amirashv/YET/yeti24/cad/step/ir_led_case.step

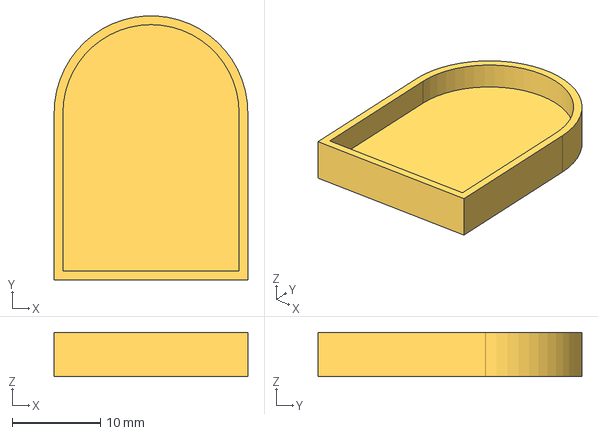
[picture p1: CAD file, 2026-02-17]
yeti24/cad/step/ir_led_case.step
22.0 x 30.0 x 5.00 mm
