amirashv/YET/yeti24/cad/stl/et_mount.step.stl

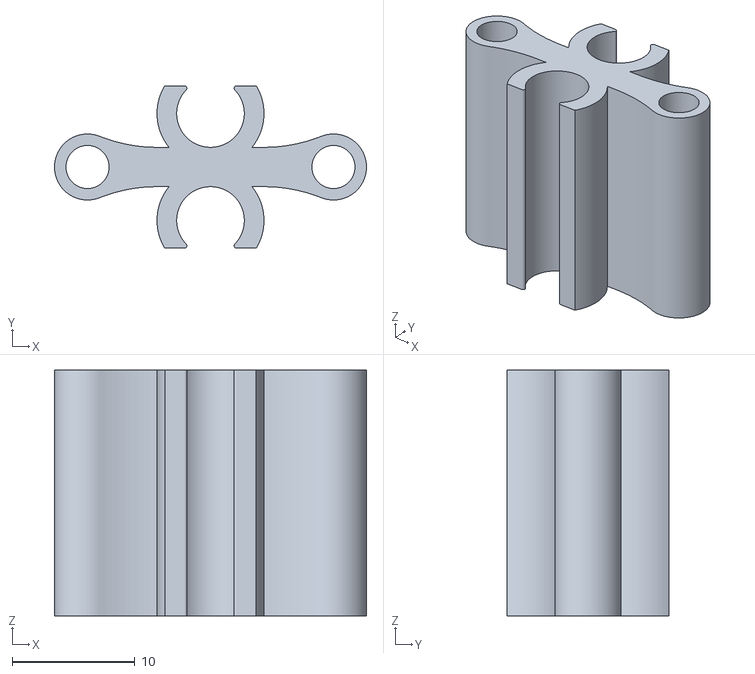
[picture p2: CAD file, 2026-02-17]
yeti24/cad/stl/et_mount.step.stl
25.4 x 13.2 x 20.0
