amirashv/YET/yeti24/cad/step/barebone_clip.step

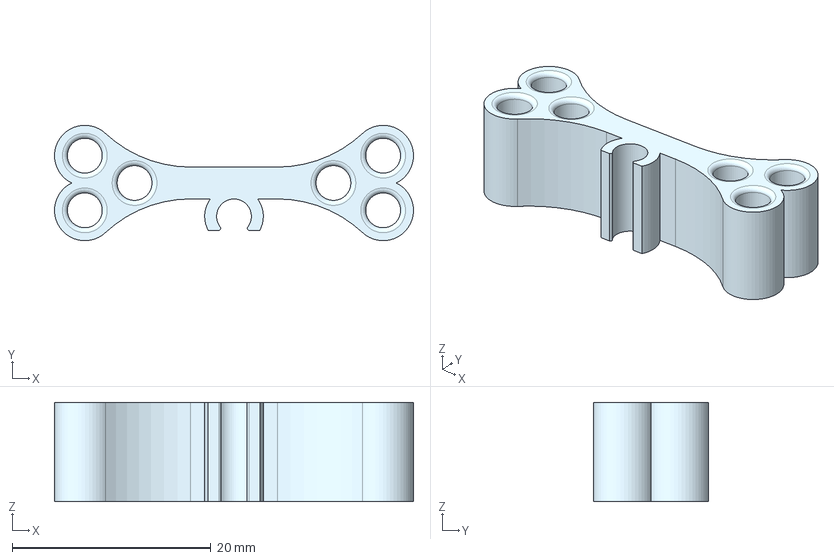
[picture p3: CAD file, 2026-02-17]
yeti24/cad/step/barebone_clip.step
36.1 x 11.6 x 10.0 mm
