amirashv/YET/yeti24/cad/step/hook.step

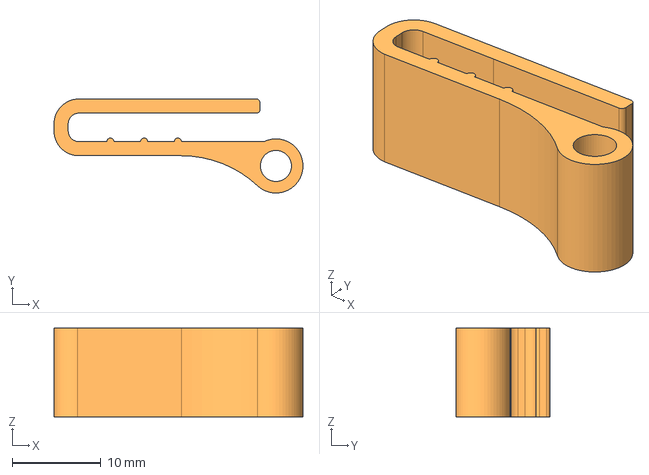
[picture p4: CAD file, 2026-02-17]
yeti24/cad/step/hook.step
28.0 x 10.6 x 10.0 mm
