amirashv/YET/yeti24/cad/step/wire_cap.step

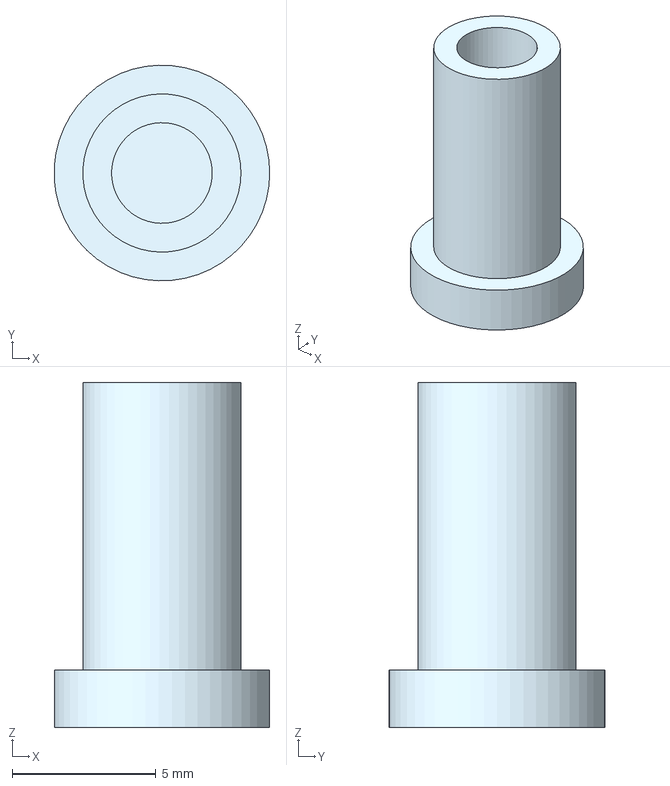
[picture p5: CAD file, 2026-02-17]
yeti24/cad/step/wire_cap.step
7.49 x 7.50 x 12.0 mm
