amirashv/YET/yeti24/cad/step/xwing_barebone.step

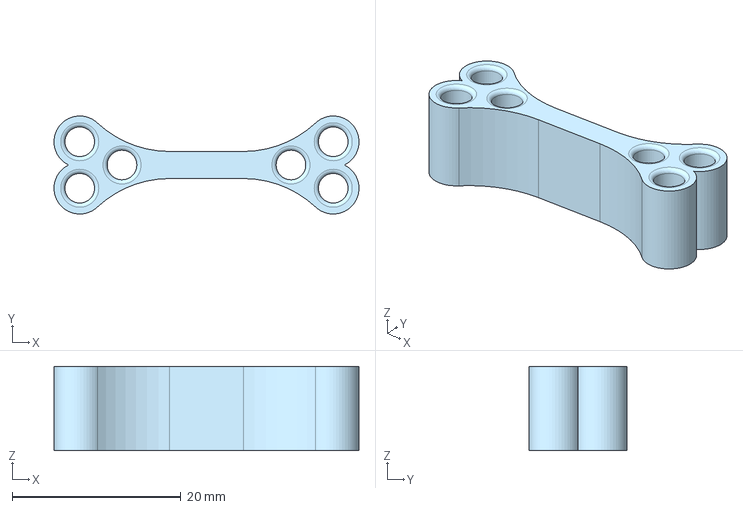
[picture p6: CAD file, 2026-02-17]
yeti24/cad/step/xwing_barebone.step
36.1 x 11.6 x 10.0 mm
