amirashv/YET/yeti24/cad/step/ir_led_clip.step

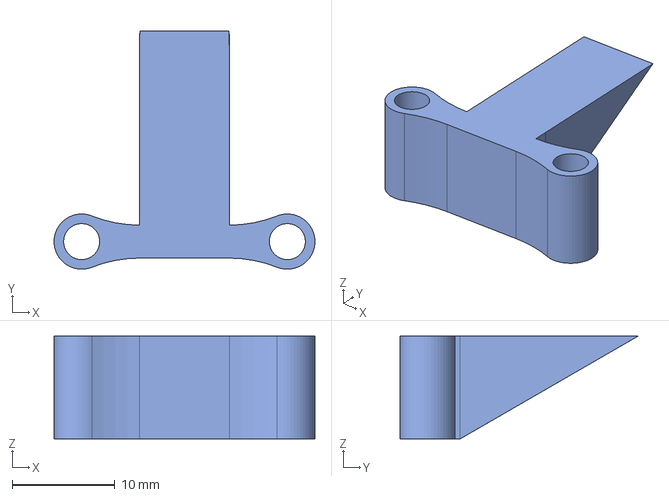
[picture p7: CAD file, 2026-02-17]
yeti24/cad/step/ir_led_clip.step
25.4 x 23.2 x 10.0 mm
