amirashv/YET/yeti24/cad/step/hook_barebone_clip.step

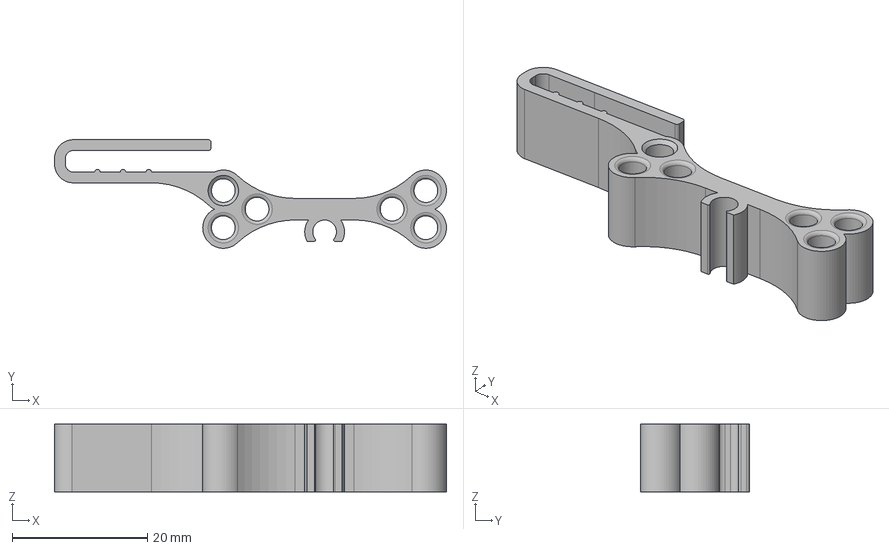
[picture p8: CAD file, 2026-02-17]
yeti24/cad/step/hook_barebone_clip.step
58.0 x 16.1 x 10.0 mm
