amirashv/YET/(list of files, cad)

Other CAD files:
yeti24/cad/step/et_mount.step
yeti24/cad/stl/barebone_clip.stl
yeti24/cad/stl/hook.stl
yeti24/cad/stl/hook_barebone_clip.stl
yeti24/cad/stl/ir_led_case.stl
yeti24/cad/stl/ir_led_clip.stl
yeti24/cad/stl/wire_cap.stl
yeti24/cad/stl/xwing_barebone.stl
