amirashv/YET/(commit log)

2025-11-21 Configure USB index for YET camera
    [Config.csv]
2026-02-17 chore: ignore macOS .DS_Store
    [AOI.csv, Config.csv, Stimuli.csv, Stimuli_short.csv, Yeta1_DemoMS1770558810.csv, Yeta1_DemoMS1770559033.csv, Yeta1_DemoMS1770561162.csv, Yeta1_DemoMS1770561335.csv]
2026-02-17 Add YETI24 module (et/cad/imu/docs) and related assets
    [imu_log_20260216_175840.csv, imu_log_20260216_175916.csv]
2026-02-28 Update yeti24 docs, imu pipeline, and project structure
2026-03-02 Update IMU analysis pipeline
